Inkozi/Eurorack_Modules/VCA/VCA BoM.xlsx

Sheet: BoM
Parts | Quantity | Unit-Price | Link
1N4148 diode | 2 | 0.1 | https://www.digikey.com/en/products/detail/on-semiconductor/1N4148/458603
TL074CN Op-Amp IC | 1 | 0.65 | https://www.digikey.com/en/products/detail/texas-instruments/TL074CN/277423
BC547 NPN Transistor | 1 | 0.05 | https://www.digikey.com/en/products/detail/fairchild-semiconductor/BC548C/11544950
Audio Jacks | 4 | 0.56 | https://www.thonk.co.uk/shop/3-5mm-jacks/
200kOhm Resistor | 0 | 0.11 | https://www.mouser.com/ProductDetail/594-5063JD200K0F
100kOhm Resistor | 7 | 0.12 | https://www.mouser.com/ProductDetail/594-5063JD100K0F
10kOhm Resistor | 1 | 0.11 | https://www.mouser.com/ProductDetail/594-5063JD10K00F

Sheet: Parts List
PART | CODE | Quantity
Resistor 470K | R10, R11 | 2
Resistor 200k | R1 | 2
Resister 100k | R4, R6, R7 | 6
Resistor 10k | R3, R8, R9 | 1
Resistor 1k | R12, R13 | 2
Resistor 100 | R5 | 1
Resistor 33k | R2 | 1
LED | D1
Transistor NPN | NPN1, 2
Audio Jack | CV, Sig, Out | 3
TL074 |  | 1
 |  | 19
