Inkozi/Eurorack_Modules/VCO/Voltage Controlled Oscillator BoM.xlsx

Sheet: BoM
Parts | Quantity | Unit-Price | Link
1N4148 diode | 2 | 0.1 | https://www.digikey.com/en/products/detail/on-semiconductor/1N4148/458603
TL074CN Op-Amp IC | 1 | 0.65 | https://www.digikey.com/en/products/detail/texas-instruments/TL074CN/277423
CD40106 Hex Inverter IC | 1 | 0.53 | https://www.digikey.com/en/products/detail/texas-instruments/CD40106BE/376602
BC548C Transistor | 1 | 0.05 | https://www.digikey.com/en/products/detail/fairchild-semiconductor/BC548C/11544950
BC558C Transistor | 1 | 0.22 | https://www.mouser.com/ProductDetail/512-BC559CTA
Thermistor | 4 | 0.35 | https://www.mouser.com/ProductDetail/594-2381-633-83103
100k potentiometer (linear) | 3 | 1.14 | https://www.thonk.co.uk/shop/alpha-9mm-pots/
1k trimmer | 1 | 1.02 | https://www.mouser.com/ProductDetail/652-3362P-1-102LF
Audio Jacks | 4 | 0.56 | https://www.thonk.co.uk/shop/3-5mm-jacks/
200kOhm Resistor | 0 | 0.11 | https://www.mouser.com/ProductDetail/594-5063JD200K0F
100kOhm Resistor | 7 | 0.12 | https://www.mouser.com/ProductDetail/594-5063JD100K0F
10kOhm Resistor | 1 | 0.11 | https://www.mouser.com/ProductDetail/594-5063JD10K00F
10kOhm Thermistor | 4 | 0.35 | https://www.mouser.com/ProductDetail/594-2381-633-83103
1uF capacitor | 2 | 1.01 | https://www.mouser.com/ProductDetail/505-MKS21-100-5
2.2nF capacitor | 1 | 0.45 | https://www.mouser.com/ProductDetail/505-FKS2D012201A00JI
1M trimmer | 1 | 1.93 | https://www.mouser.com/ProductDetail/Bourns/3296W-1-105LF?qs=XW6UEr546KK%2FVdIHsKCpmg%3D%3D

Sheet: Parts List
PART | CODE | Quantity
Resistor 1M | R2, R6, | 2
Resister 100k | R1, R4, R7, R9, R12, R13 | 6
Resistor 10k | R3 | 1
Resistor 20k | R11, R18 | 2
Resistor 1k5 | R5 | 1
Resistor 33k | R8 | 1
Resistor 200k | R10, | 1
Trimmer 1k | 1KTRIM1 | 1
Capacitor 1uF | C1 C3 | 2
Capacitor 2.2nF | C2 | 1
Diode | D1, D2 | 2
PART | CODE | 2
Resistor 1M | R15, R20 | 6
Resister 100k | R14, R17, R21, R27, R26, R25 | 1
Resistor 10k | R16 | 2
Resistor 20k | R24, R28 | 1
Resistor 1k5 | R19 | 1
Resistor 33k | R22 | 1
Resistor 200k | R23 | 1
Trimmer 1k | 1KTRIM2 | 2
Capacitor 1uF | C4, C6 | 1
Capacitor 2.2nF | C5 | 2
Diode | D3, D4
PART | CODE
Resistor 1M | R30, R34 | 2
Resister 100k | R29, R32, R35, R41, R40, R39 | 6
Resistor 10k | R31 | 1
Resistor 20k | R38, R42 | 2
Resistor 1k5 | R33 | 1
Resistor 33k | R36 | 1
Resistor 200k | R37 | 1
Trimmer 1k | 1KTRIM3 | 1
Capacitor 1uF | C7, C9 | 2
Capacitor 2.2nF | C8 | 1
Diode | D5, D6 | 2
Transistor PNP | PNP1, 2, 3 | 3
Transistor NPN | NPN1, 2, 3 | 3
Thermistor | T1, T2, T3 | 3
10x connector |  | 3
 |  | 72
