Inkozi/Eurorack_Modules/VCO/TriVCO_board_layout_FINAL_edited_10-22.brd

## EAGLE design VCO/TriVCO_board_layout_FINAL_edited_10-22.brd (2021-10-29)

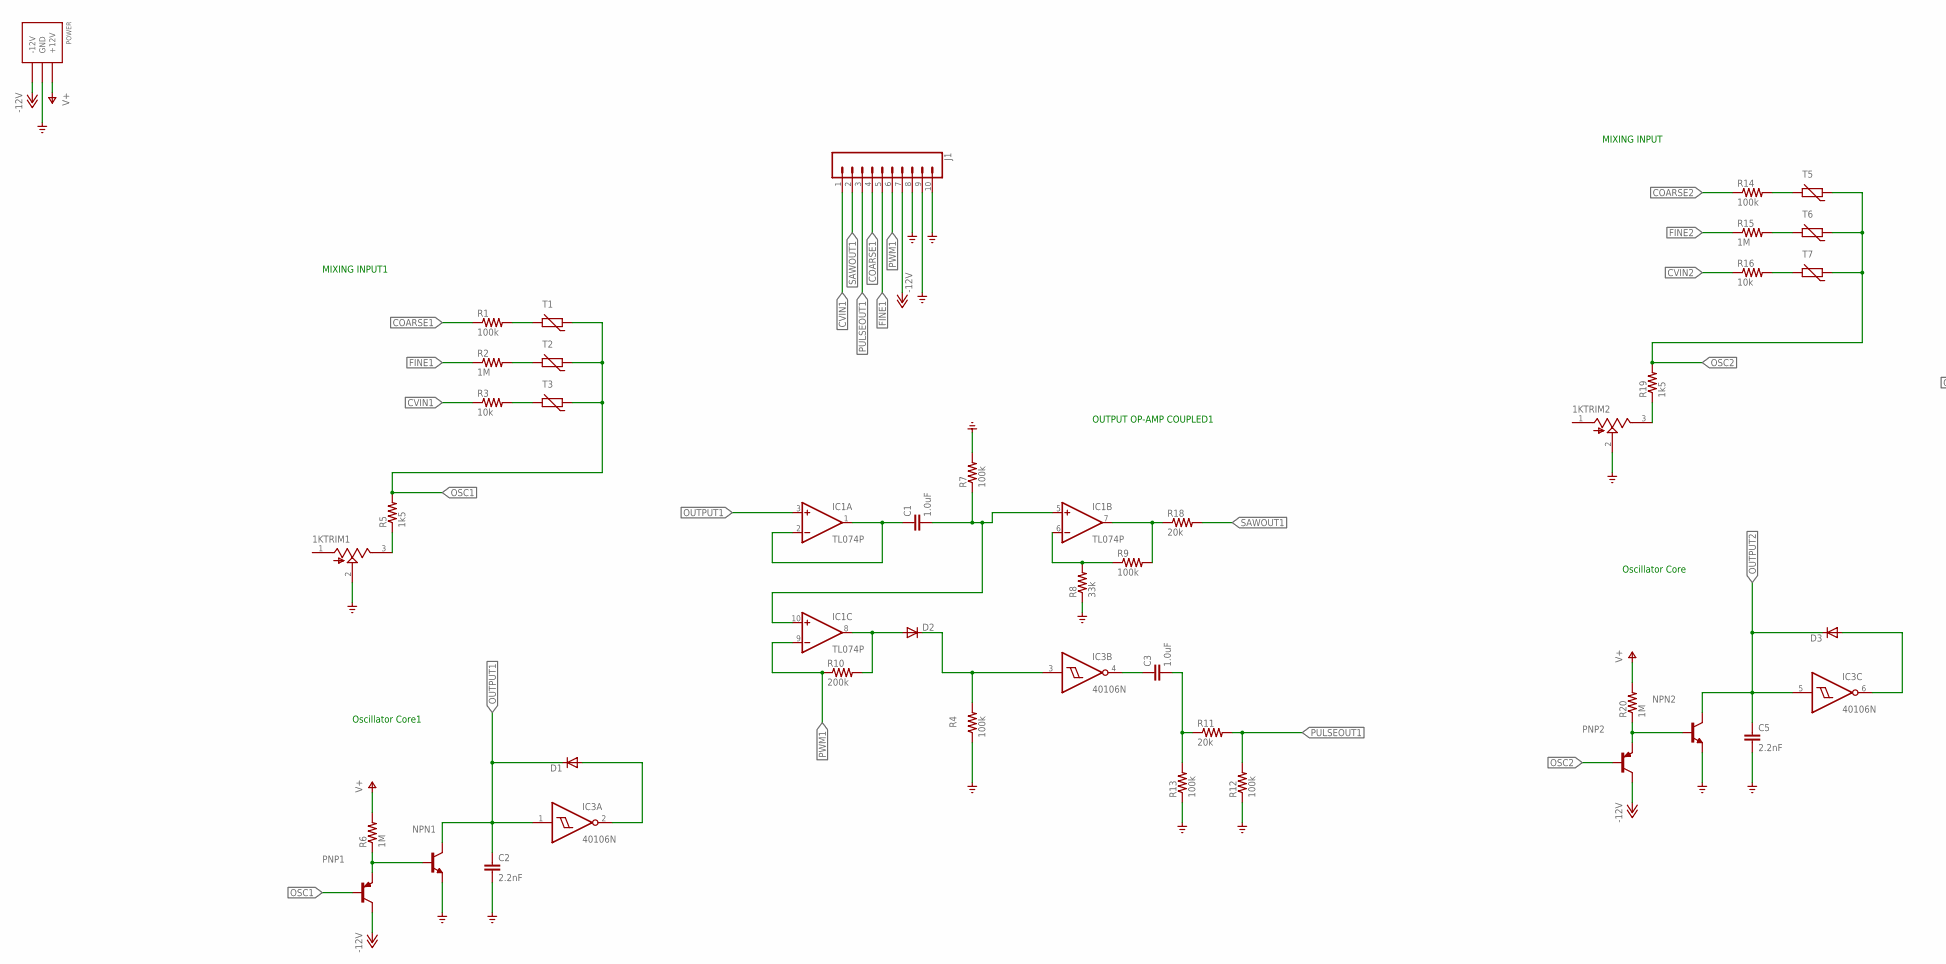
[picture p1: schematic TriVCO_board_layout_FINAL_edited_10-22.sch, part in row 1, column 1]

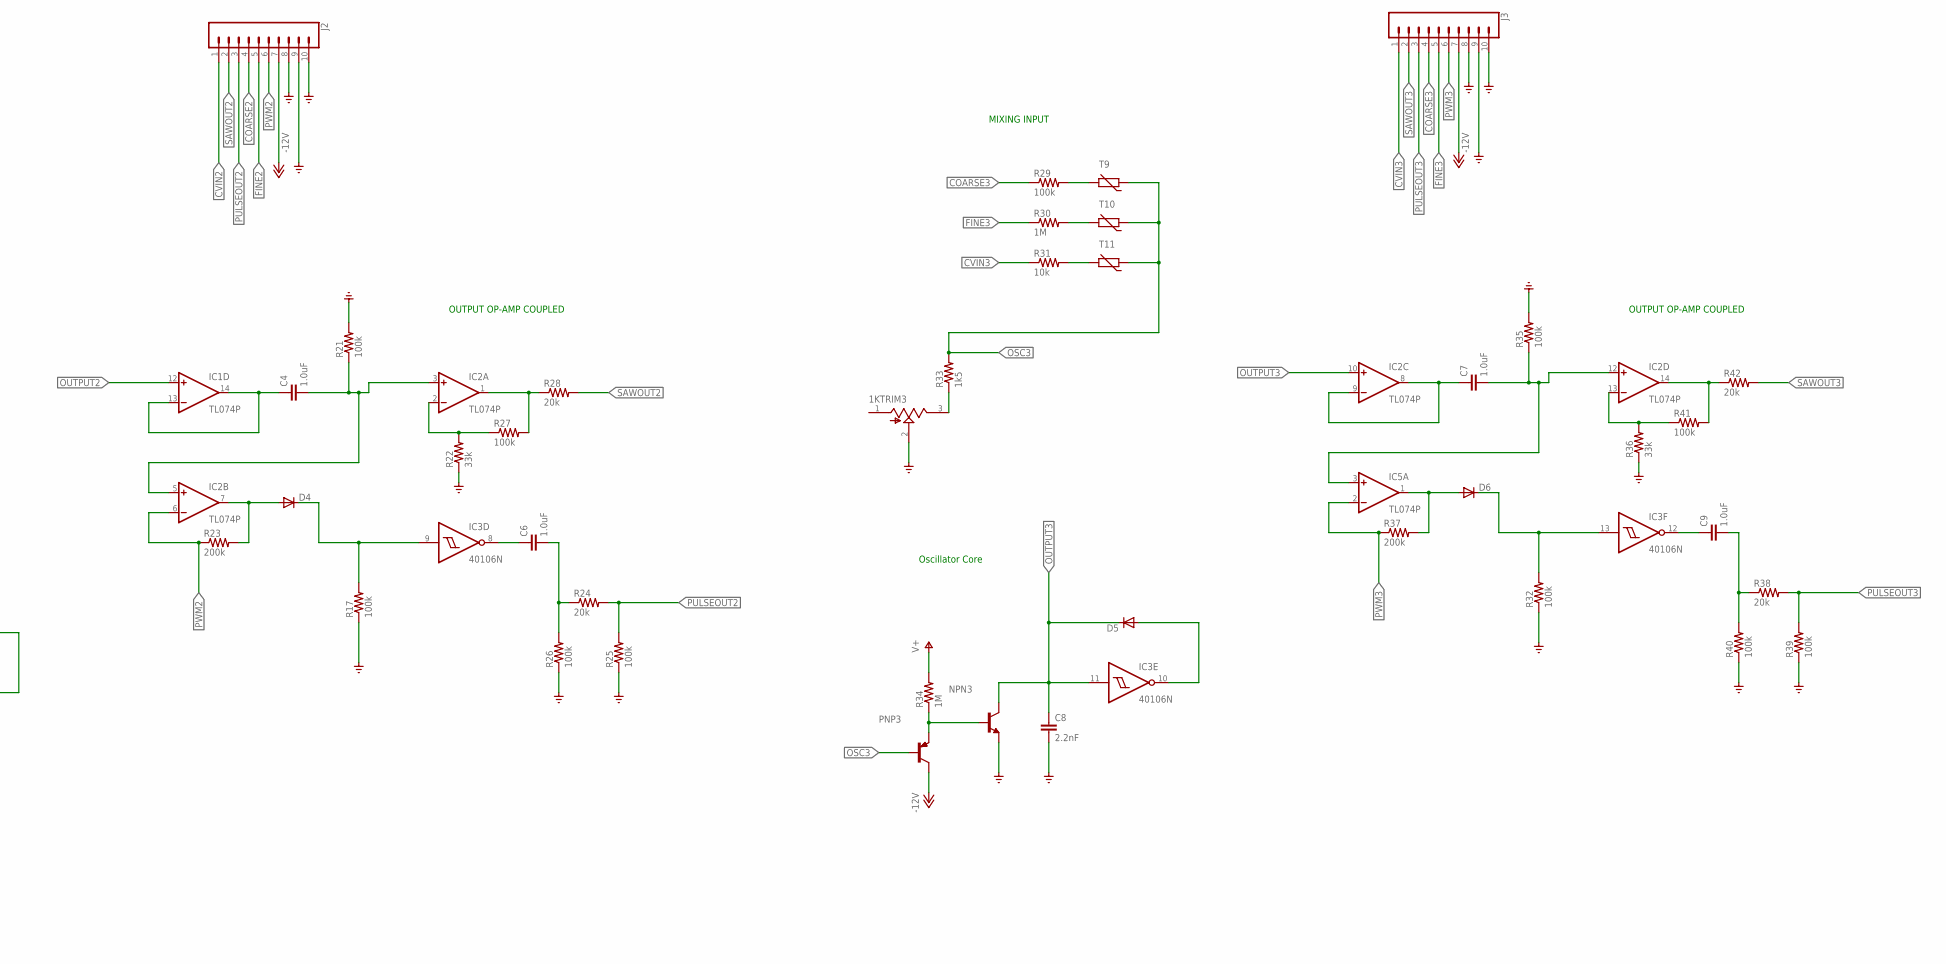
[picture p2: schematic TriVCO_board_layout_FINAL_edited_10-22.sch, part in row 1, column 2]

Parts:
1KTRIM1, 1KTRIM2, 1KTRIM3: 3362P-1-102LF; TRIM_3362P-1-102LF
C1, C4, C7: 1.0uF; 0603
C2, C5, C8: 2.2nF; 0603
C3, C6, C9: 1.0uF; 0402
D1, D2, D3, D4, D5, D6: 1N4148DO35-7; DO35-7
IC1, IC2, IC5: TL074P; DIL14
IC3: 40106N; DIL14
J1, J2, J3: CONN_10"; 1X10
NPN1, NPN2, NPN3: BC485-NPN-TO92-CBE; TO92-CBE
PNP1, PNP2, PNP3: BC450-PNP-TO92-EBC; TO92-EBC
POWER: POWER_SIMPLE10; POWER_10
R1, R4, R7, R9, R12, R13, R14, R17, R21, R25, R26, R27, R29, R32, R35, R39, R40, R41: 100k; 0207/10
R2, R6, R15, R20, R30, R34: 1M; 0207/10
R3, R16, R31: 10k; 0207/10
R5, R19, R33: 1k5; 0207/10
R8, R22, R36: 33k; 0207/10
R10, R23, R37: 200k; 0207/10
R11, R18, R24, R28, R38, R42: 20k; 0207/10
T1, T2, T3, T5, T6, T7, T9, T10, T11: THERMISTOR-5; R-5

Connections:
COARSE1: J1.4, R1.1
COARSE2: J2.4, R14.1
COARSE3: J3.4, R29.1
CVIN1: J1.1, R3.1
CVIN2: J2.1, R16.1
CVIN3: J3.1, R31.1
FINE1: J1.5, R2.1
FINE2: J2.5, R15.1
FINE3: J3.5, R30.1
GND: 1KTRIM1.2 (WIPER), 1KTRIM2.2 (WIPER), 1KTRIM3.2 (WIPER), C2.2, C5.2, C8.2, IC3.7 (VSS), J1.8, J1.9, J1.10, J2.8, J2.9, J2.10, J3.8, J3.9, J3.10, NPN1.E, NPN2.E, NPN3.E, POWER.3 (GND), POWER.4 (GND), POWER.5 (GND), POWER.6 (GND), POWER.7 (GND), POWER.8 (GND), R4.1, R7.2, R8.1, R12.1, R13.1, R17.1, R21.2, R22.1, R25.1, R26.1, R32.1, R35.2, R36.1, R39.1, R40.1
unnamed: R14.2, T5.2
unnamed: R1.2, T1.2
unnamed: R15.2, T6.2
unnamed: R2.2, T2.2
unnamed: R16.2, T7.2
unnamed: 1KTRIM2.3 (CW), R19.1
unnamed: R3.2, T3.2
unnamed: 1KTRIM1.3 (CW), R5.1
unnamed: NPN1.B, PNP1.E, R6.1
unnamed: NPN2.B, PNP2.E, R20.1
unnamed: D1.A, IC3.2 (O)
unnamed: D3.A, IC3.6 (O)
unnamed: C1.1, IC1.1 (OUT), IC1.2 (-IN)
unnamed: C1.2, IC1.5 (+IN), IC1.10 (+IN), R7.1
unnamed: IC1.6 (-IN), R8.2, R9.1
unnamed: IC1.7 (OUT), R9.2, R18.1
unnamed: C4.1, IC1.13 (-IN), IC1.14 (OUT)
unnamed: D2.A, IC1.8 (OUT), R10.2
unnamed: C4.2, IC2.3 (+IN), IC2.5 (+IN), R21.1
unnamed: D2.C, IC3.3 (I), R4.2
unnamed: C3.1, IC3.4 (O)
unnamed: C3.2, R11.1, R13.2
unnamed: IC2.2 (-IN), R22.2, R27.1
unnamed: IC2.1 (OUT), R27.2, R28.1
unnamed: D4.A, IC2.7 (OUT), R23.2
unnamed: D4.C, IC3.9 (I), R17.2
unnamed: C6.1, IC3.8 (O)
unnamed: C6.2, R24.1, R26.2
unnamed: R29.2, T9.2
unnamed: R30.2, T10.2
unnamed: R31.2, T11.2
unnamed: 1KTRIM3.3 (CW), R33.1
unnamed: NPN3.B, PNP3.E, R34.1
unnamed: D5.A, IC3.10 (O)
unnamed: C7.1, IC2.8 (OUT), IC2.9 (-IN)
unnamed: C7.2, IC2.12 (+IN), IC5.3 (+IN), R35.1
unnamed: IC2.13 (-IN), R36.2, R41.1
unnamed: IC2.14 (OUT), R41.2, R42.1
unnamed: D6.A, IC5.1 (OUT), R37.2
unnamed: D6.C, IC3.13 (I), R32.2
unnamed: C9.1, IC3.12 (O)
unnamed: C9.2, R38.1, R40.2
OSC1: PNP1.B, R5.2, T1.1, T2.1, T3.1
OSC2: PNP2.B, R19.2, T5.1, T6.1, T7.1
OSC3: PNP3.B, R33.2, T9.1, T10.1, T11.1
OUTPUT1: C2.1, D1.C, IC1.3 (+IN), IC3.1 (I), NPN1.C
OUTPUT2: C5.1, D3.C, IC1.12 (+IN), IC3.5 (I), NPN2.C
OUTPUT3: C8.1, D5.C, IC2.10 (+IN), IC3.11 (I), NPN3.C
PULSEOUT1: J1.3, R11.2, R12.2
PULSEOUT2: J2.3, R24.2, R25.2
PULSEOUT3: J3.3, R38.2, R39.2
PWM1: IC1.9 (-IN), J1.6, R10.1
PWM2: IC2.6 (-IN), J2.6, R23.1
PWM3: IC5.2 (-IN), J3.6, R37.1
SAWOUT1: J1.2, R18.2
SAWOUT2: J2.2, R28.2
SAWOUT3: J3.2, R42.2
V+: IC1.4 (V+), IC2.4 (V+), IC3.14 (VDD), IC5.4 (V+), POWER.9 (+12V), POWER.10 (+12V), R6.2, R20.2, R34.2
V-: IC1.11 (V-), IC2.11 (V-), IC5.11 (V-), J1.7, J2.7, J3.7, PNP1.C, PNP2.C, PNP3.C, POWER.1 (-12V), POWER.2 (-12V)

Notes on the sheet:
Oscillator Core1
Oscillator Core
OUTPUT OP-AMP COUPLED
OUTPUT OP-AMP COUPLED1
MIXING INPUT
MIXING INPUT1

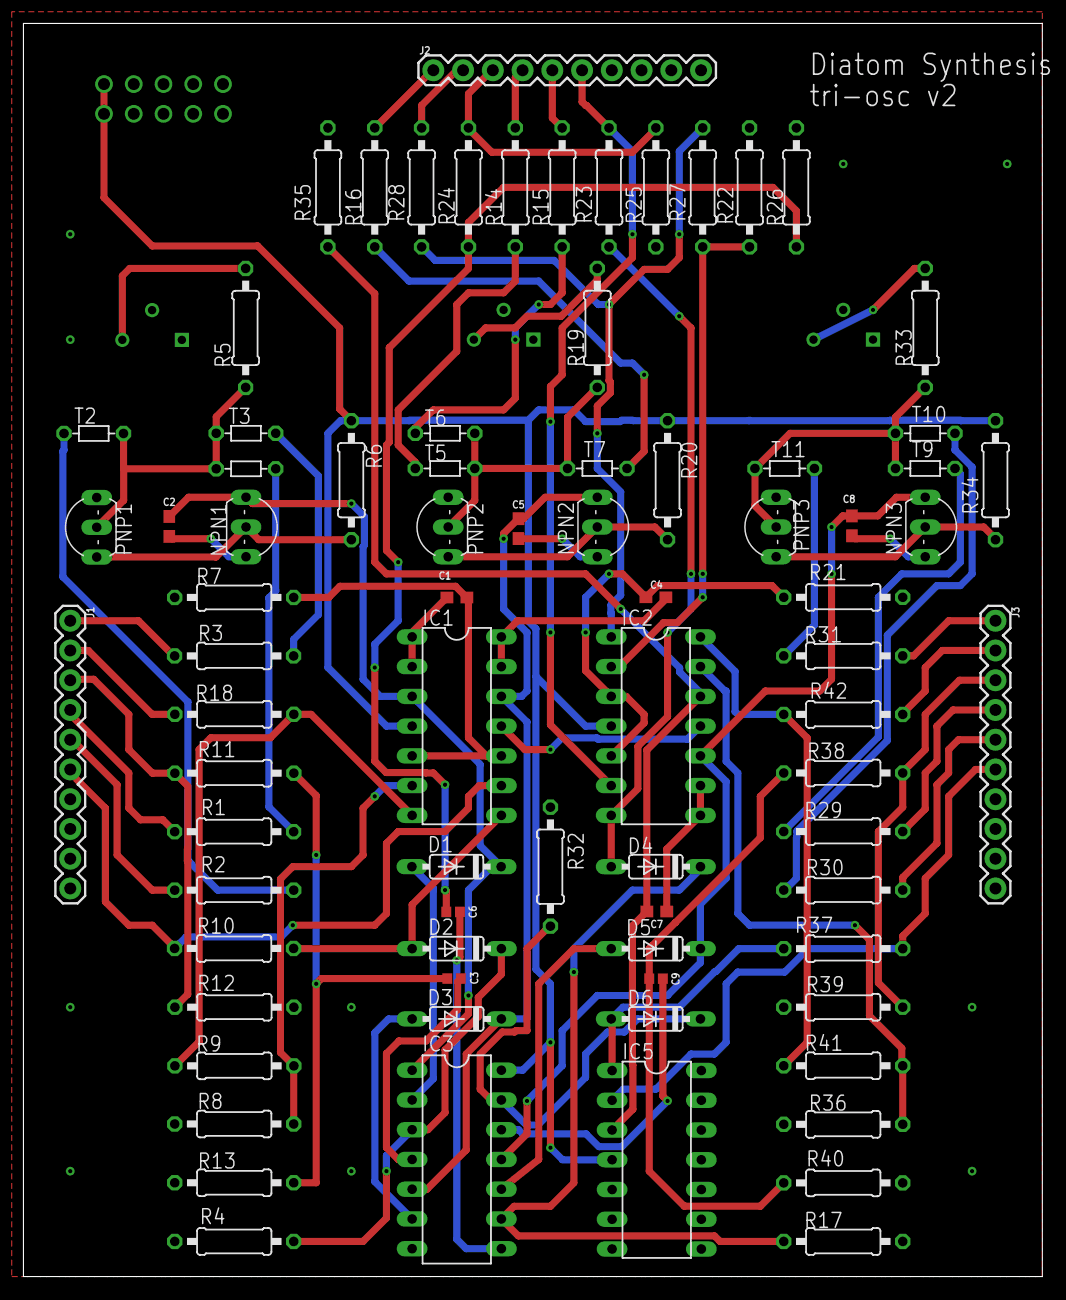
[picture p3: board TriVCO_board_layout_FINAL_edited_10-22.brd from above]

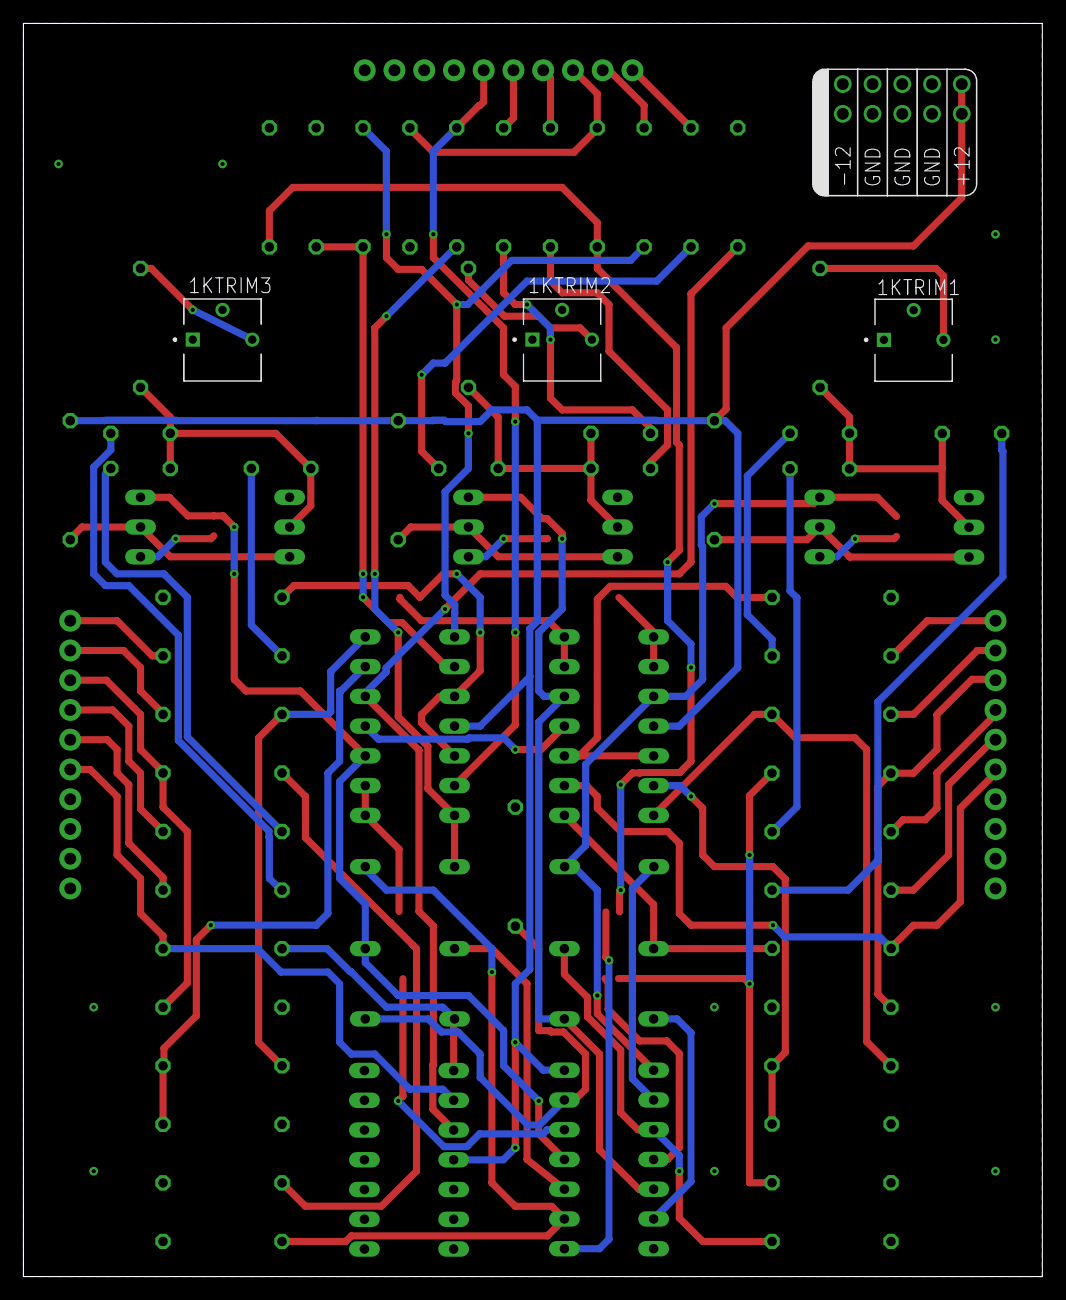
[picture p4: board TriVCO_board_layout_FINAL_edited_10-22.brd from below]

Board: 2 copper layers, 87.0 x 107.0 mm, 83 parts (4 on the bottom side), 69 nets.
