Inkozi/Eurorack_Modules/VCO/VCO_knobs_and_jacks_edited.brd

## EAGLE design VCO/VCO_knobs_and_jacks_edited.brd (2021-10-29)

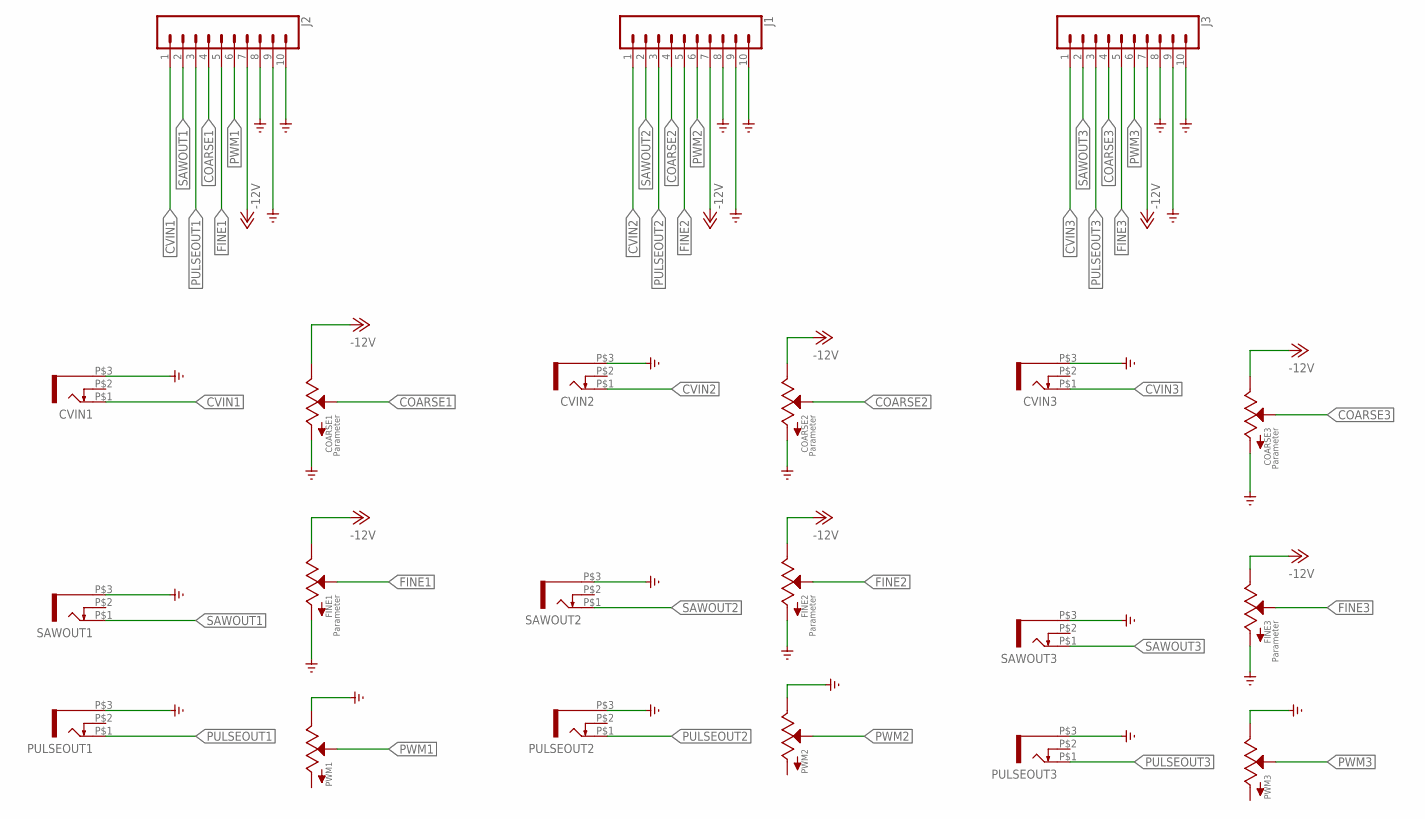
[picture p5: schematic VCO_knobs_and_jacks_edited.sch]

Parts:
COARSE1, COARSE2, COARSE3: POTZEPHPOT; OG-POTS_ALPS_POT_VERTICAL
CVIN1, CVIN2, CVIN3: WQP-PJ301M-12_JACK
FINE1, FINE2, FINE3: POTZEPHPOT; OG-POTS_ALPS_POT_VERTICAL
J1, J2, J3: CONN_10"; 1X10
PULSEOUT1, PULSEOUT2, PULSEOUT3: WQP-PJ301M-12_JACK
PWM1, PWM2, PWM3: POTZEPHPOT; OG-POTS_ALPS_POT_VERTICAL
SAWOUT1, SAWOUT2, SAWOUT3: WQP-PJ301M-12_JACK

Connections:
-12V: COARSE1.P$1 (E), COARSE2.P$1 (E), COARSE3.P$1 (E), FINE1.P$1 (E), FINE2.P$1 (E), FINE3.P$1 (E), J1.7, J2.7, J3.7
COARSE1: COARSE1.P$2 (S), J2.4
COARSE2: COARSE2.P$2 (S), J1.4
COARSE3: COARSE3.P$2 (S), J3.4
CVIN1: CVIN1.P$1 (2), J2.1
CVIN2: CVIN2.P$1 (2), J1.1
CVIN3: CVIN3.P$1 (2), J3.1
FINE1: FINE1.P$2 (S), J2.5
FINE2: FINE2.P$2 (S), J1.5
FINE3: FINE3.P$2 (S), J3.5
GND: COARSE1.P$3 (A), COARSE2.P$3 (A), COARSE3.P$3 (A), CVIN1.P$3 (1), CVIN2.P$3 (1), CVIN3.P$3 (1), FINE1.P$3 (A), FINE2.P$3 (A), FINE3.P$3 (A), J1.8, J1.9, J1.10, J2.8, J2.9, J2.10, J3.8, J3.9, J3.10, PULSEOUT1.P$3 (1), PULSEOUT2.P$3 (1), PULSEOUT3.P$3 (1), PWM1.P$1 (E), PWM2.P$1 (E), PWM3.P$1 (E), SAWOUT1.P$3 (1), SAWOUT2.P$3 (1), SAWOUT3.P$3 (1)
PULSEOUT1: J2.3, PULSEOUT1.P$1 (2)
PULSEOUT2: J1.3, PULSEOUT2.P$1 (2)
PULSEOUT3: J3.3, PULSEOUT3.P$1 (2)
PWM1: J2.6, PWM1.P$2 (S)
PWM2: J1.6, PWM2.P$2 (S)
PWM3: J3.6, PWM3.P$2 (S)
SAWOUT1: J2.2, SAWOUT1.P$1 (2)
SAWOUT2: J1.2, SAWOUT2.P$1 (2)
SAWOUT3: J3.2, SAWOUT3.P$1 (2)

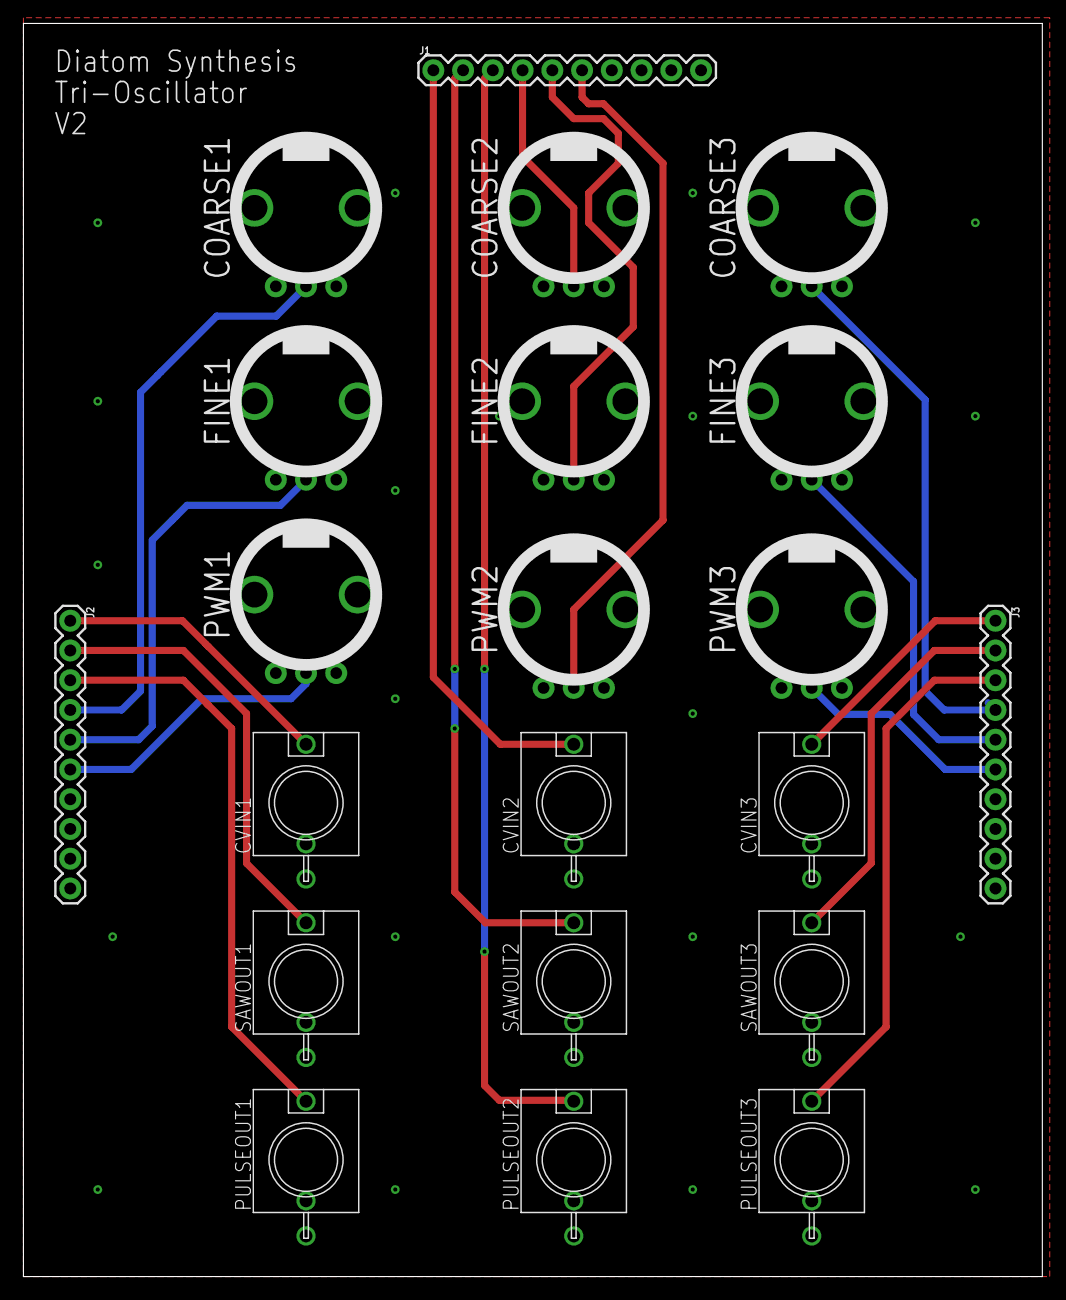
[picture p6: board VCO_knobs_and_jacks_edited.brd from above]

Board: 2 copper layers, 87.0 x 107.0 mm, 21 parts (0 on the bottom side), 20 nets.
