Inkozi/Eurorack_Modules/VCA/VCA.brd

## EAGLE design VCA/VCA.brd (2021-10-29)

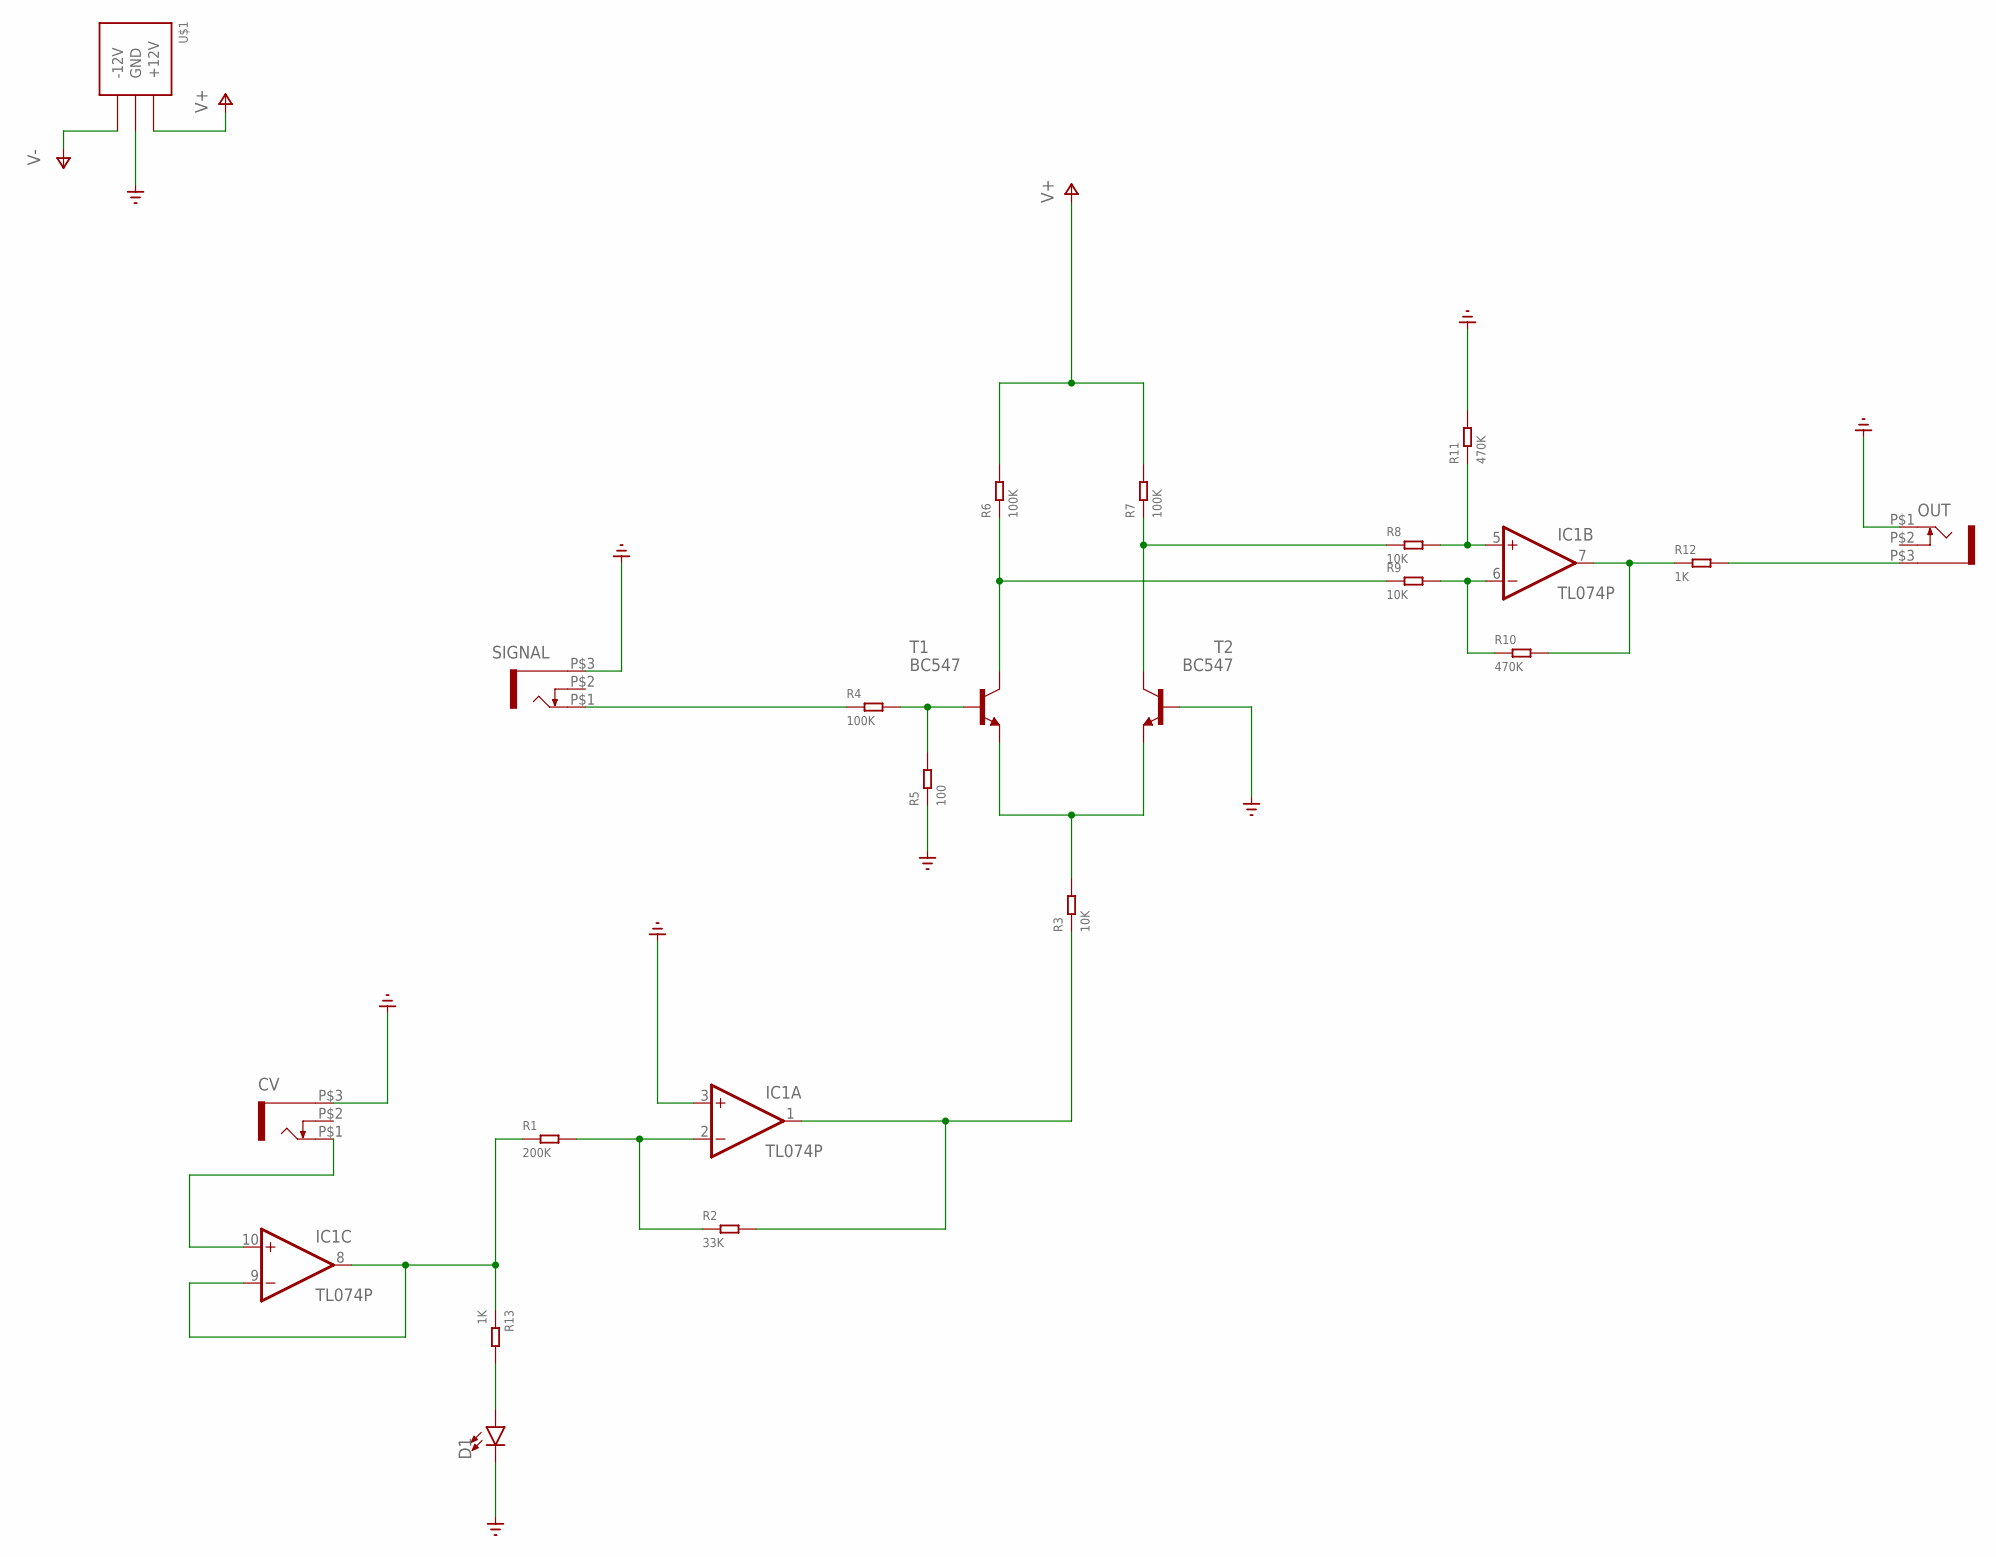
[picture p7: schematic VCA.sch]

Parts:
CV: WQP-PJ301M-12_JACK
D1: LED3MM; LED_3MM
IC1: TL074P; DIL14
OUT: WQP-PJ301M-12_JACK
R1: 200K; PR-D2.3XL6.5MM
R2: 33K; PR-D2.3XL6.5MM
R3, R8, R9: 10K; PR-D2.3XL6.5MM
R4, R6, R7: 100K; PR-D2.3XL6.5MM
R5: 100; PR-D2.3XL6.5MM
R10, R11: 470K; PR-D2.3XL6.5MM
R12, R13: 1K; PR-D2.3XL6.5MM
SIGNAL: WQP-PJ301M-12_JACK
T1, T2: BC547; TO92
U$1: POWER_SIMPLE10; POWER_10

Connections:
GND: CV.P$3 (1), D1.K (C), IC1.3 (+IN), OUT.P$1 (2), R5.1, R11.2, SIGNAL.P$3 (1), T2.2 (B), U$1.3 (GND), U$1.4 (GND), U$1.5 (GND), U$1.6 (GND), U$1.7 (GND), U$1.8 (GND)
unnamed: IC1.2 (-IN), R1.2, R2.1
unnamed: R3.2, T1.1 (E), T2.1 (E)
unnamed: IC1.1 (OUT), R2.2, R3.1
unnamed: R4.1, SIGNAL.P$1 (2)
unnamed: R4.2, R5.2, T1.2 (B)
unnamed: CV.P$1 (2), IC1.10 (+IN)
unnamed: R6.1, R9.1, T1.3 (C)
unnamed: R7.1, R8.1, T2.3 (C)
unnamed: IC1.8 (OUT), IC1.9 (-IN), R1.1, R13.1
unnamed: IC1.5 (+IN), R8.2, R11.1
unnamed: IC1.6 (-IN), R9.2, R10.1
unnamed: IC1.7 (OUT), R10.2, R12.1
unnamed: OUT.P$3 (1), R12.2
unnamed: D1.A, R13.2
V+: IC1.4 (V+), R6.2, R7.2, U$1.9 (+12V), U$1.10 (+12V)
V-: IC1.11 (V-), U$1.1 (-12V), U$1.2 (-12V)

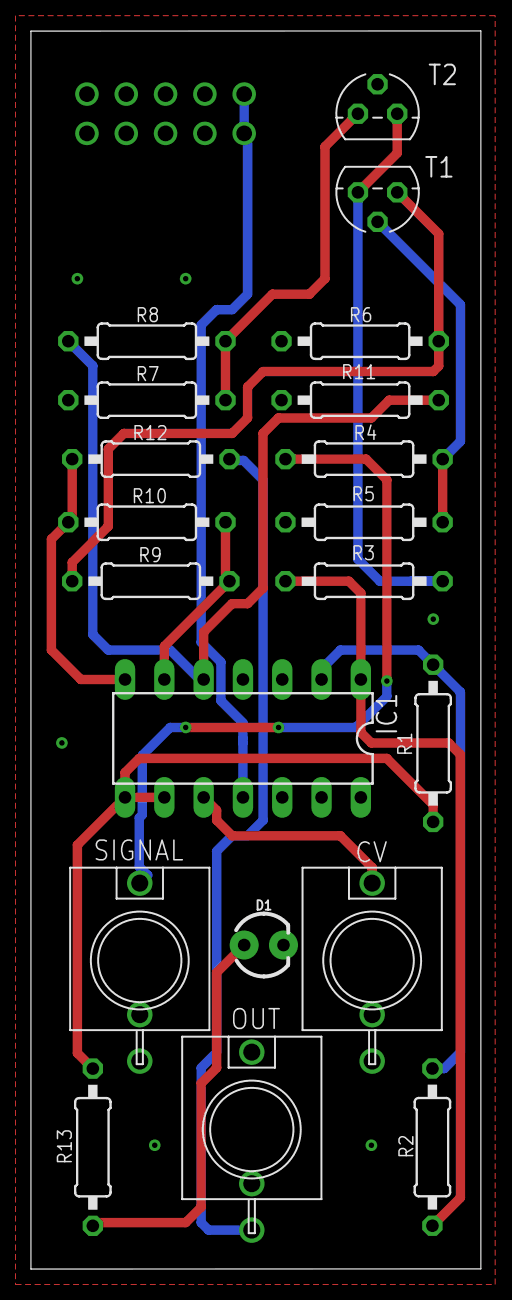
[picture p8: board VCA.brd from above]

Board: 2 copper layers, 29.1 x 80.0 mm, 21 parts (1 on the bottom side), 17 nets.
