Inkozi/Eurorack_Modules/VCO/TODO.txt

Source new Trimmers
Figure out tuning protocol and document
Fix cutoff of PWM Pot
Fix Channel two on PCB (maybe solder a new one?)

DONE
Flip Trimmers
