Inkozi/Eurorack_Modules/(commit log)

2021-10-29 Add files via upload
    Added Finalized VCA schematic and pcb.
    [VCA.brd, VCA.sch]
2021-10-29 Add files via upload
    VCO, still a work in progress but getting close.
    [TriVCO_board_layout_FINAL_edited_10-22.brd, TriVCO_board_layout_FINAL_edited_10-22.sch, VCO_knobs_and_jacks_edited.brd, VCO_knobs_and_jacks_edited.sch]
2021-10-29 Add files via upload
    Bill of Materials and Parts List
    [Voltage Controlled Oscillator BoM.xlsx]
